empirephoenix/DCBrushedMotorController/sheets/112423_w01_abmessung_1920x1920.jpg

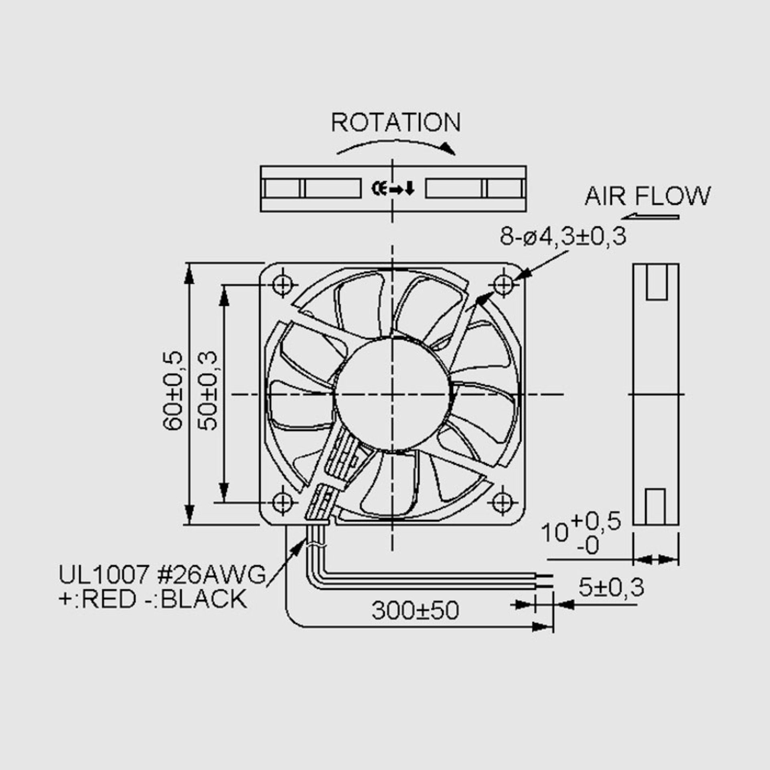
sheets/112423_w01_abmessung_1920x1920.jpg
