empirephoenix/DCBrushedMotorController/sheets/s-l1600.jpg

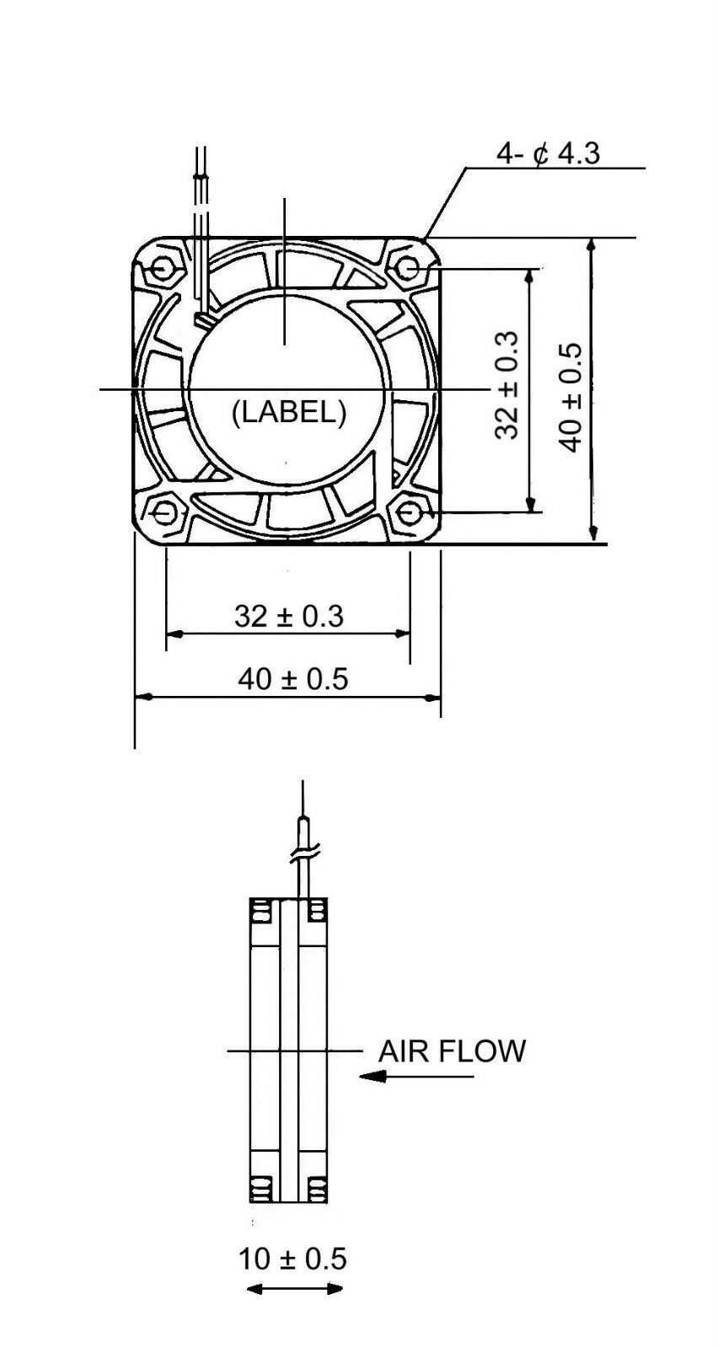
sheets/s-l1600.jpg
