empirephoenix/DCBrushedMotorController/board2/DCMotorController/DCMotorController.kicad_pcb

## KiCad design board2/DCMotorController/DCMotorController.kicad_pcb (2024-08-04)

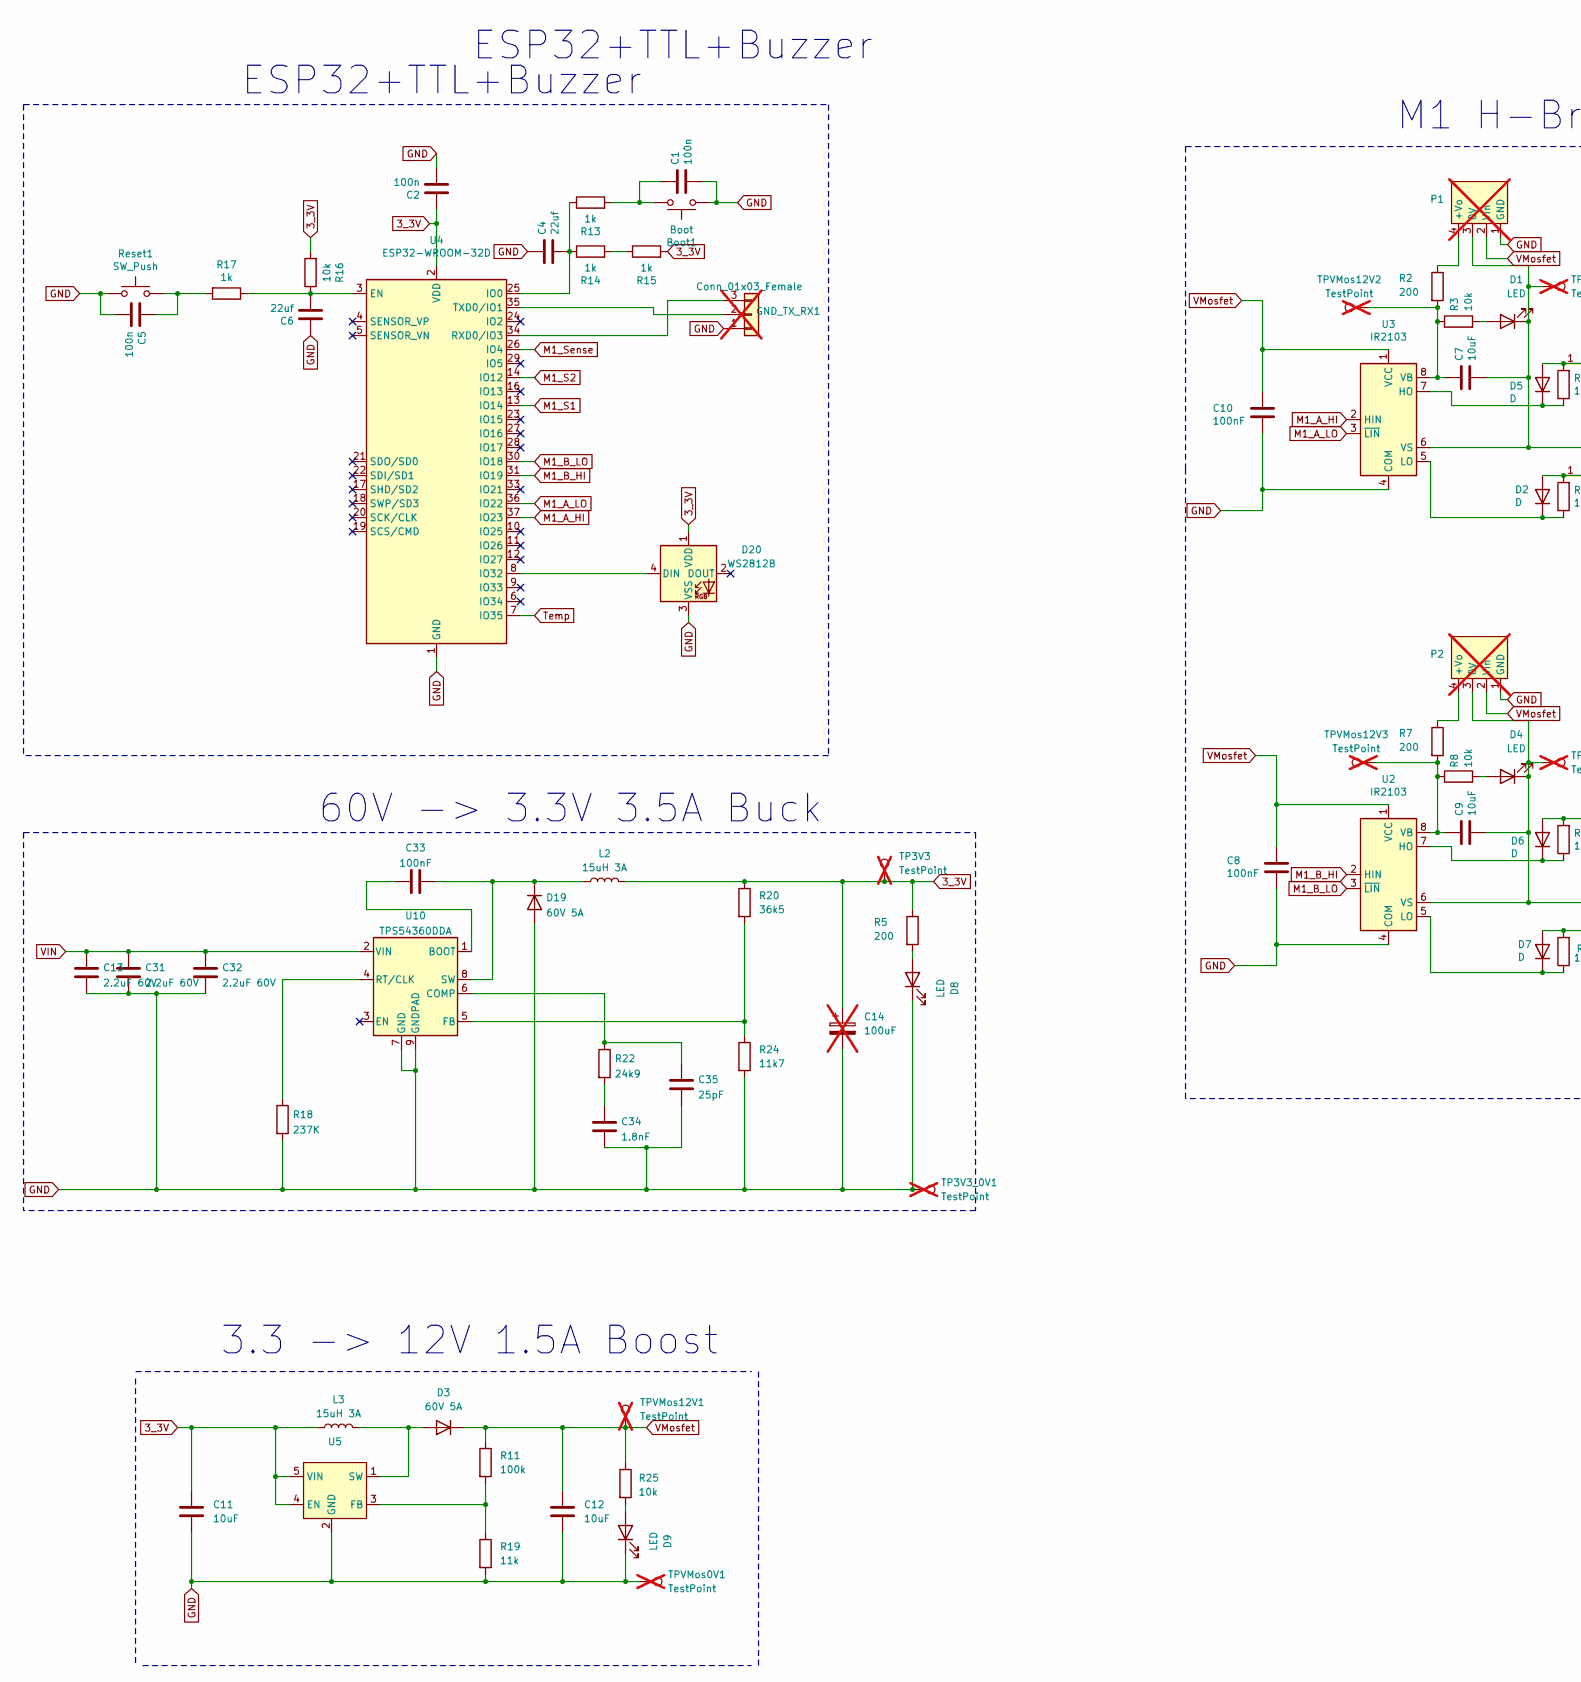
[picture p3: schematic DCMotorController.kicad_sch, part in row 1, column 1]

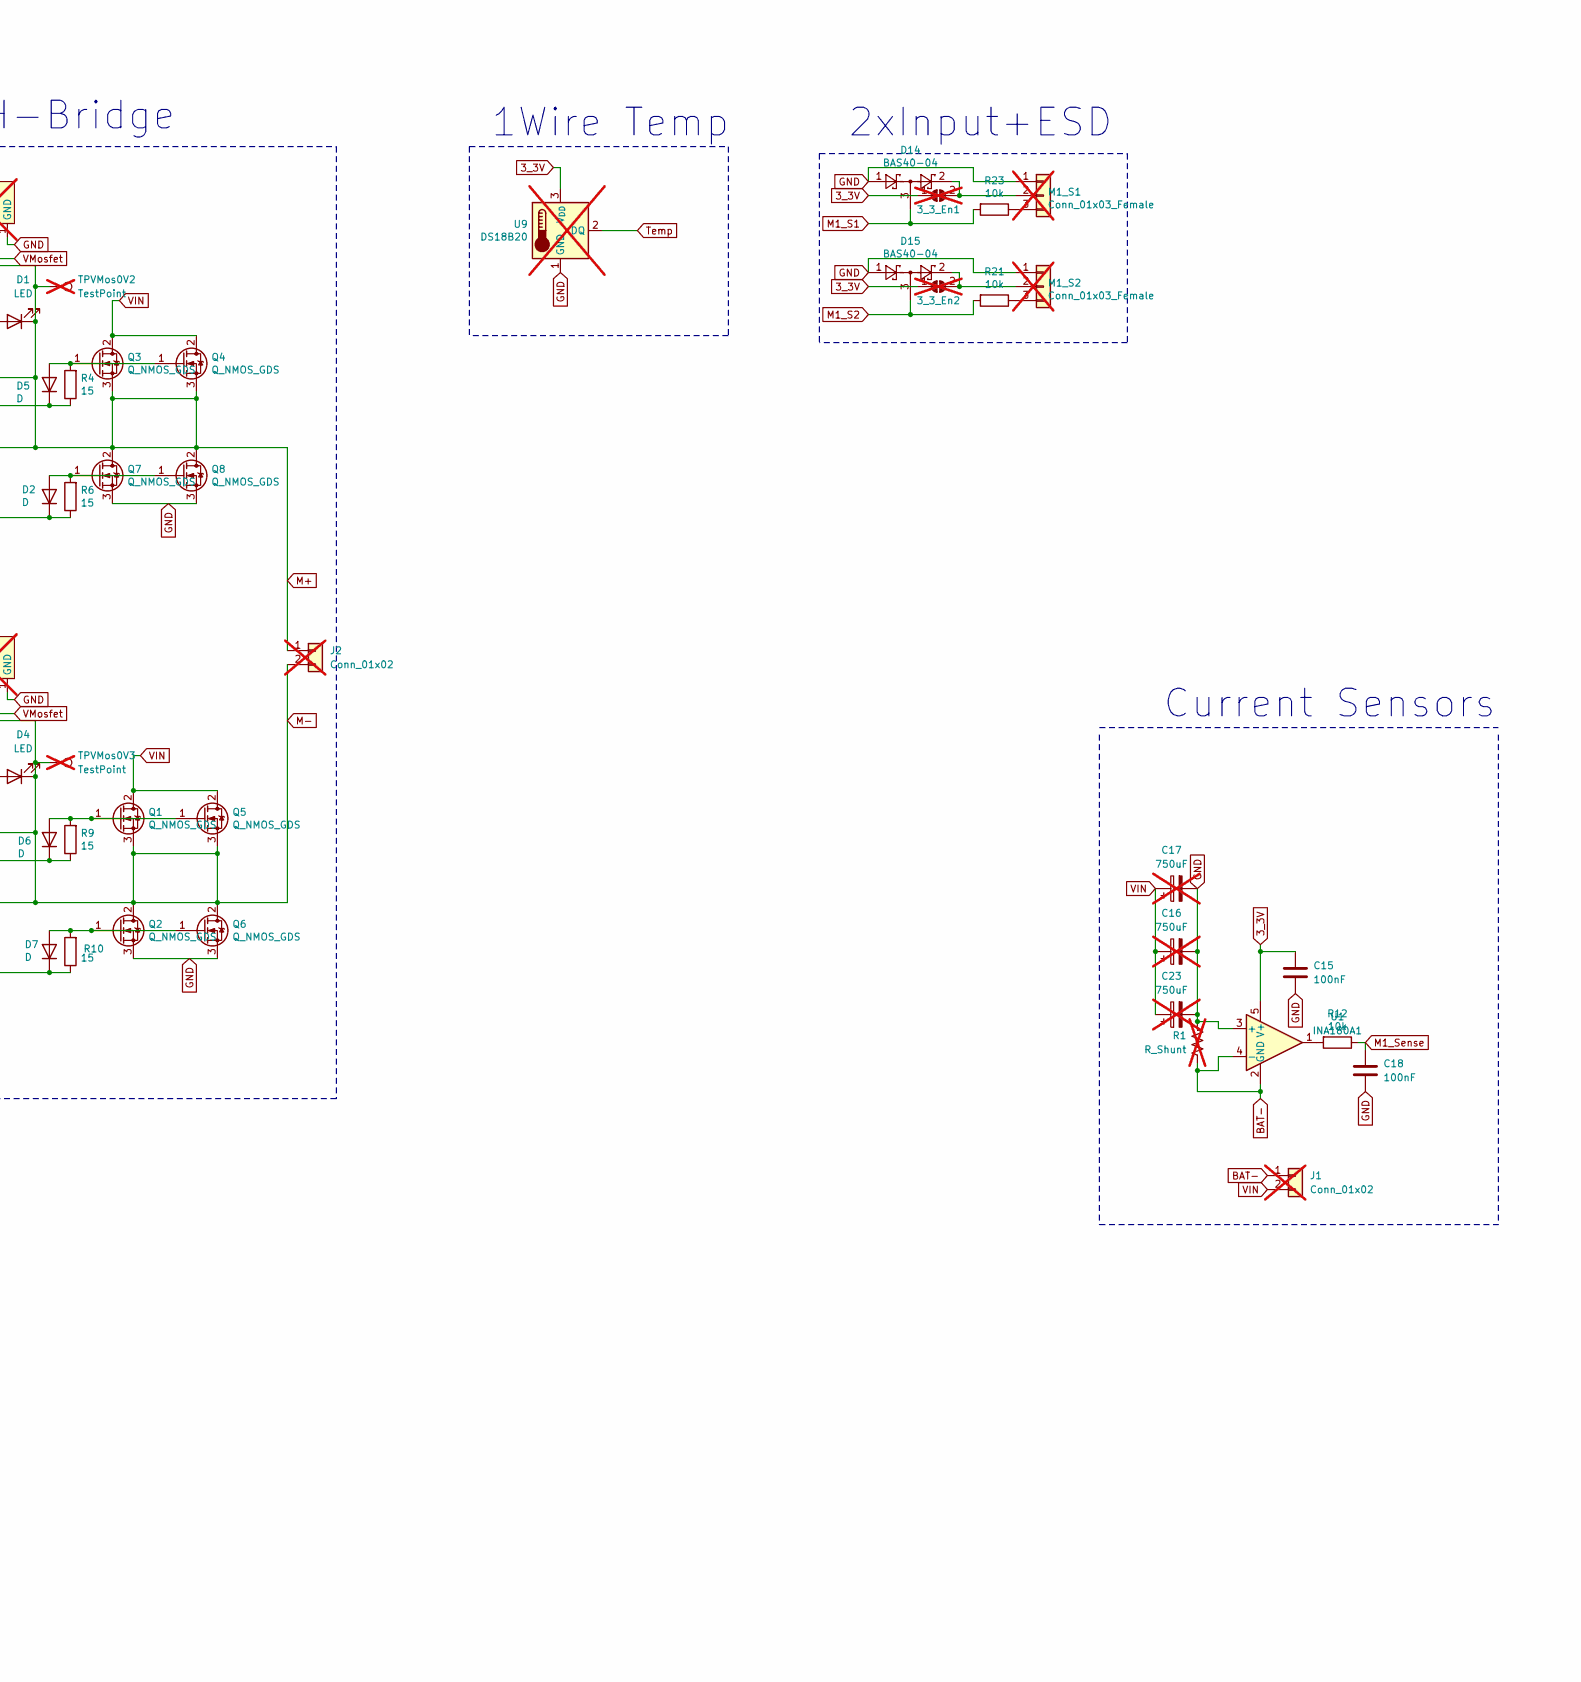
[picture p4: schematic DCMotorController.kicad_sch, part in row 1, column 2]

Parts:
3_3_En1, 3_3_En2: SolderJumper-2_P1.3mm_Open_RoundedPad1.0x1.5mm; not fitted
Boot1: Boot; SW_SPST_CK_RS282G05A3; LCSC C72443
C1, C2, C5: 100n; C_0603_1608Metric; LCSC C14663
C4, C6: 22uf; C_0805_2012Metric; LCSC C5674
C7, C9: 10uF; C_1206_3216Metric; LCSC C13585
C8, C10, C15, C18, C33: 100nF; C_0603_1608Metric; LCSC C14663
C11, C12: 10uF; C_1206_3216Metric
C13, C31, C32: 2.2uF 60V; C_1206_3216Metric; LCSC C920964
C14: 100uF; CP_Radial_D10.0mm_P2.50mm_P5.00mm; not fitted
C16, C17, C23: 750uF; CP_Radial_D12.5mm_P5.00mm; LCSC C316460; not fitted
C34: 1.8nF; C_0603_1608Metric; LCSC C1599
C35: 25pF; C_0603_1608Metric; LCSC C282067
D1, D4, D8, D9: LED; LED_0805_2012Metric
D2, D5, D6, D7: D; D_SOD-123; LCSC C81598
D3, D19: 60V 5A; D_SMA; LCSC C513479
D14, D15: BAS40-04; SOT-23; LCSC C397601
D20: WS2812B; LED_WS2812B_PLCC4_5.0x5.0mm_P3.2mm; LCSC no
GND_TX_RX1: Conn_01x03_Female; PinHeader_1x03_P2.54mm_Vertical; LCSC no; not fitted
J1: Conn_01x02; AMASS_XT60-M_1x02_P7.20mm_Vertical; not fitted
J2: Conn_01x02; AMASS_XT60-F_1x02_P7.20mm_Vertical; not fitted
L2, L3: 15uH 3A; L_10.4x10.4_H4.8; LCSC C151872
M1_S1, M1_S2: Conn_01x03_Female; PinHeader_1x03_P2.54mm_Vertical; LCSC no; not fitted
P1, P2: Converter_DCDC_TRACO_TEA1-xxxx_THT; LCSC C7465190; not fitted
Q1, Q2, Q3, Q4, Q5, Q6, Q7, Q8: Q_NMOS_GDS; TO-252-2; LCSC C110912
R1: R_Shunt; Shunt 1moh 5W; LCSC C695947; not fitted
R2, R5, R7: 200; R_0603_1608Metric; LCSC C25217
R3, R8, R25: 10k; R_0603_1608Metric
R4, R6, R9, R10: 15; R_0603_1608Metric; LCSC C22810
R11: 100k; R_0603_1608Metric; LCSC C22797
R12, R16, R21, R23: 10k; R_0603_1608Metric; LCSC C25804
R13, R14, R15, R17: 1k; R_0603_1608Metric; LCSC C21190
R18: 237K; R_0603_1608Metric_Pad0.98x0.95mm_HandSolder; LCSC C2998117
R19: 11k; R_0603_1608Metric; LCSC C25950
R20: 36k5; R_0603_1608Metric; LCSC C2930095
R22: 24k9; R_0603_1608Metric; LCSC C25962
R24: 11k7; R_0805_2012Metric; LCSC C865154
Reset1: SW_Push; SW_SPST_CK_RS282G05A3; LCSC C72443
TP3V3, TP3V3_0V1: TestPoint; TestPoint_Pad_2.0x2.0mm; not fitted
TPVMos0V1, TPVMos0V2, TPVMos0V3, TPVMos12V1, TPVMos12V2, TPVMos12V3: TestPoint; TestPoint_Pad_2.0x2.0mm; not fitted
U1: INA180A1; SOT-23-5; LCSC C122228
U2, U3: IR2103; SOP-8_3.9x4.9mm_P1.27mm; LCSC C111908
U4: ESP32-WROOM-32D; ESP32-WROOM-32_no_wifi; LCSC C529578
U5: SOT-23-5; LCSC C181744
U9: DS18B20; TO-92_Inline; LCSC lcsc; not fitted
U10: TPS54360DDA; TI_SO-PowerPAD-8_ThermalVias; LCSC C44377

Connections:
3_3V: 3_3_En1.1 (A), 3_3_En2.1 (A), C2.2, C11.1, C14.1, C15.1, D20.1 (VDD), L2.2, L3.1, R5.1, R15.2, R16.2, R20.1, TP3V3.1, U1.5 (V+), U4.2 (VDD), U5.4 (EN), U5.5 (VIN), U9.3 (V_{DD})
BAT-: J1.1, R1.2, U1.2 (GND), U1.4 (-)
GND: Boot1.1, C1.1, C2.1, C4.1, C5.1, C6.1, C8.2, C10.2, C11.2, C12.2, C13.2, C14.2, C15.2, C16.2, C17.2, C18.1, C23.2, C31.2, C32.2, C34.2, C35.2, D8.1 (K), D9.1 (K), D14.1, D15.1, D19.2 (A), D20.3 (VSS), GND_TX_RX1.1, M1_S1.1, M1_S2.1, P1.1 (GND), P2.1 (GND), Q2.3 (S), Q6.3 (S), Q7.3 (S), Q8.3 (S), R1.1, R18.2, R19.2, R24.2, Reset1.1, TP3V3_0V1.1, TPVMos0V1.1, U1.3 (+), U2.4 (COM), U3.4 (COM), U4.1 (GND), U4.15 (GND), U4.38 (GND), U4.39 (GND), U5.2 (GND), U9.1 (GND), U10.7 (GND), U10.9 (GNDPAD)
M1_A_HI: U3.2 (HIN), U4.37 (IO23)
M1_A_LO: U3.3 (~LIN), U4.36 (IO22)
M1_B_HI: U2.2 (HIN), U4.31 (IO19)
M1_B_LO: U2.3 (~LIN), U4.30 (IO18)
M1_S1: D14.3, R23.2, U4.13 (IO14)
M1_S2: D15.3, R21.2, U4.14 (IO12)
M1_Sense: C18.2, R12.1, U4.26 (IO4)
M+: C7.2, D1.1 (K), J2.1, P1.3 (0V), Q3.3 (S), Q4.3 (S), Q7.2 (D), Q8.2 (D), TPVMos0V2.1, U3.6 (VS)
M-: C9.2, D4.1 (K), J2.2, P2.3 (0V), Q1.3 (S), Q2.2 (D), Q5.3 (S), Q6.2 (D), TPVMos0V3.1, U2.6 (VS)
unnamed: 3_3_En1.2 (B), D14.2, M1_S1.2
unnamed: 3_3_En2.2 (B), D15.2, M1_S2.2
unnamed: Boot1.2, C1.2, R13.2
unnamed: C5.2, R17.2, Reset1.2
unnamed: C34.1, R22.2
unnamed: D1.2 (A), R3.2
unnamed: D2.2 (A), Q7.1 (G), Q8.1 (G), R6.2
unnamed: D2.1 (K), R6.1, U3.5 (LO)
unnamed: D3.2 (A), L3.2, U5.1 (SW)
unnamed: D4.2 (A), R8.2
unnamed: D5.2 (A), Q3.1 (G), Q4.1 (G), R4.2
unnamed: D5.1 (K), R4.1, U3.7 (HO)
unnamed: D6.2 (A), Q1.1 (G), Q5.1 (G), R9.2
unnamed: D6.1 (K), R9.1, U2.7 (HO)
unnamed: D7.2 (A), Q2.1 (G), Q6.1 (G), R10.2
unnamed: D7.1 (K), R10.1, U2.5 (LO)
unnamed: D8.2 (A), R5.2
unnamed: D9.2 (A), R25.2
unnamed: C33.2, D19.1 (K), L2.1, U10.8 (SW)
unnamed: D20.4 (DIN), U4.8 (IO32)
unnamed: GND_TX_RX1.2, U4.35 (TXD0/IO1)
unnamed: GND_TX_RX1.3, U4.34 (RXD0/IO3)
unnamed: M1_S1.3, R23.1
unnamed: M1_S2.3, R21.1
unnamed: P1.4 (+Vo), R2.1
unnamed: P2.4 (+Vo), R7.1
unnamed: R12.2, U1.1
unnamed: R14.2, R15.1
unnamed: C9.1, R7.2, R8.1, TPVMos12V3.1, U2.8 (VB)
unnamed: C7.1, R2.2, R3.1, TPVMos12V2.1, U3.8 (VB)
unnamed: C6.2, R16.1, R17.1, U4.3 (EN)
unnamed: C4.2, R13.1, R14.1, U4.25 (IO0)
unnamed: R11.2, R19.1, U5.3 (FB)
unnamed: C33.1, U10.1 (BOOT)
unnamed: C35.1, R22.1, U10.6 (COMP)
unnamed: R20.2, R24.1, U10.5 (FB)
unnamed: R18.1, U10.4 (RT/CLK)
Temp: U4.7 (IO35), U9.2 (DQ)
VIN: C13.1, C16.1, C17.1, C23.1, C31.1, C32.1, J1.2, Q1.2 (D), Q3.2 (D), Q4.2 (D), Q5.2 (D), U10.2 (VIN)
VMosfet: C8.1, C10.1, C12.1, D3.1 (K), P1.2 (Vin), P2.2 (Vin), R11.1, R25.1, TPVMos12V1.1, U2.1 (VCC), U3.1 (VCC)

Notes on the sheet:
Current Sensors
3.3 -> 12V 1.5A Boost
60V -> 3.3V 3.5A Buck
ESP32+TTL+Buzzer
1Wire Temp
2xInput+ESD
M1 H-Bridge

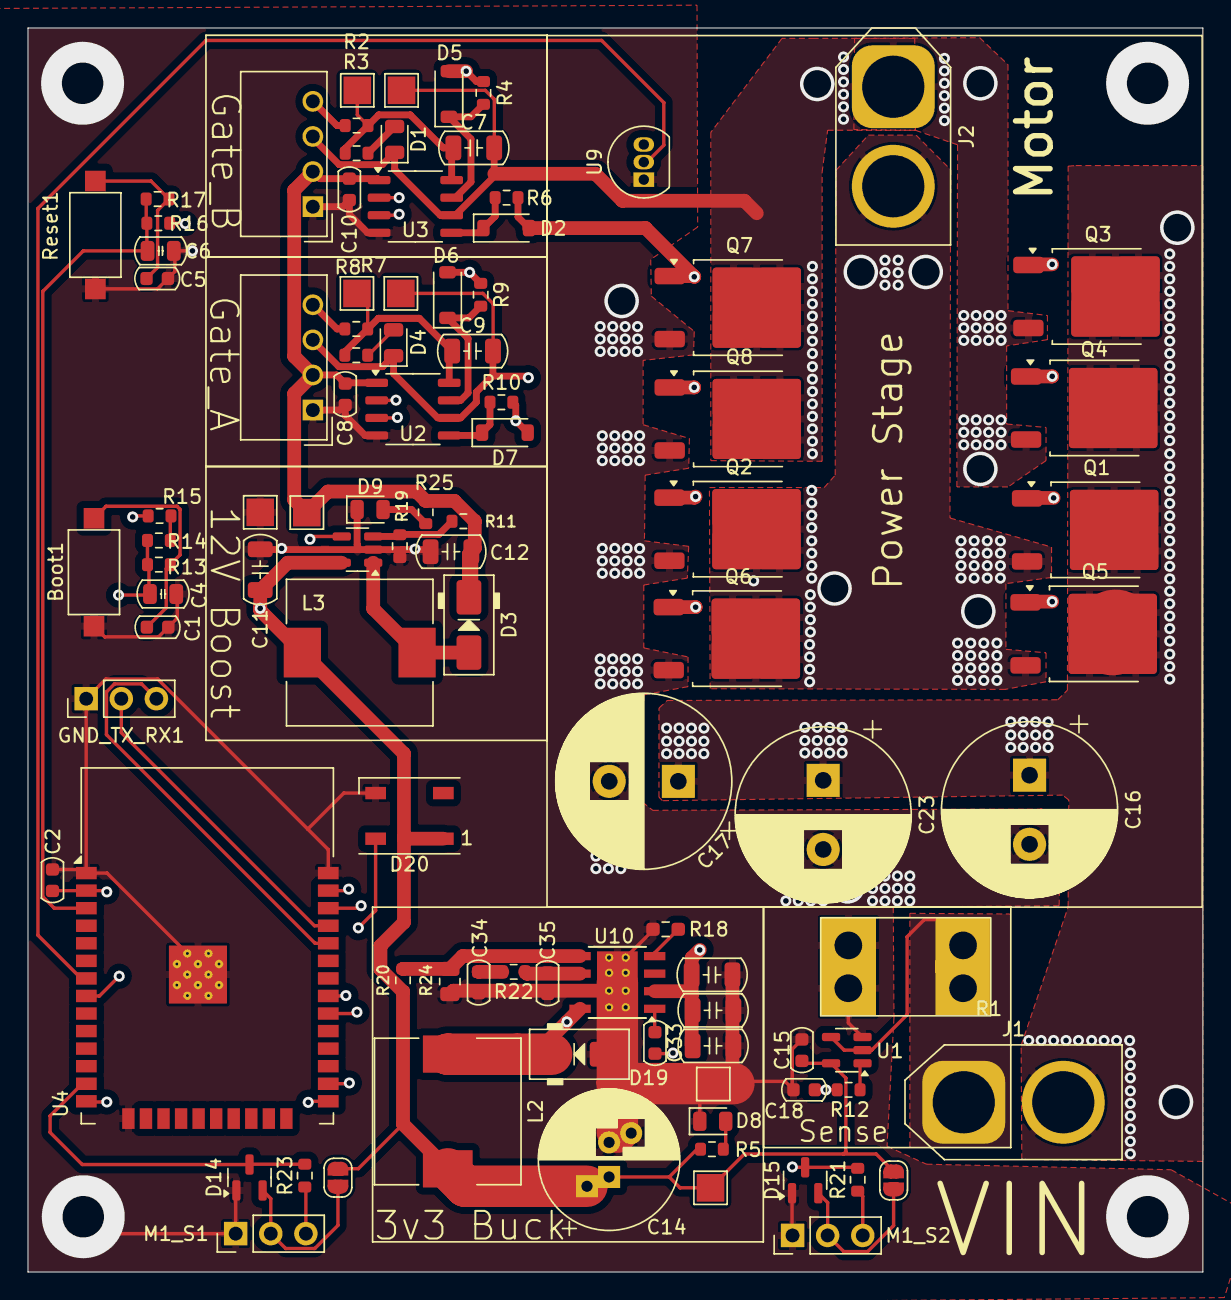
[picture p5: board board2/DCMotorController/DCMotorController.kicad_pcb from above]

Board: 4 copper layers, 85.0 x 90.0 mm, 97 parts (0 on the bottom side), 52 nets.
