empirephoenix/DCBrushedMotorController/board/5V-Downstepper/DCMotorController/DCMotorController.kicad_pcb

## KiCad design board/5V-Downstepper/DCMotorController/DCMotorController.kicad_pcb (2023-06-17)

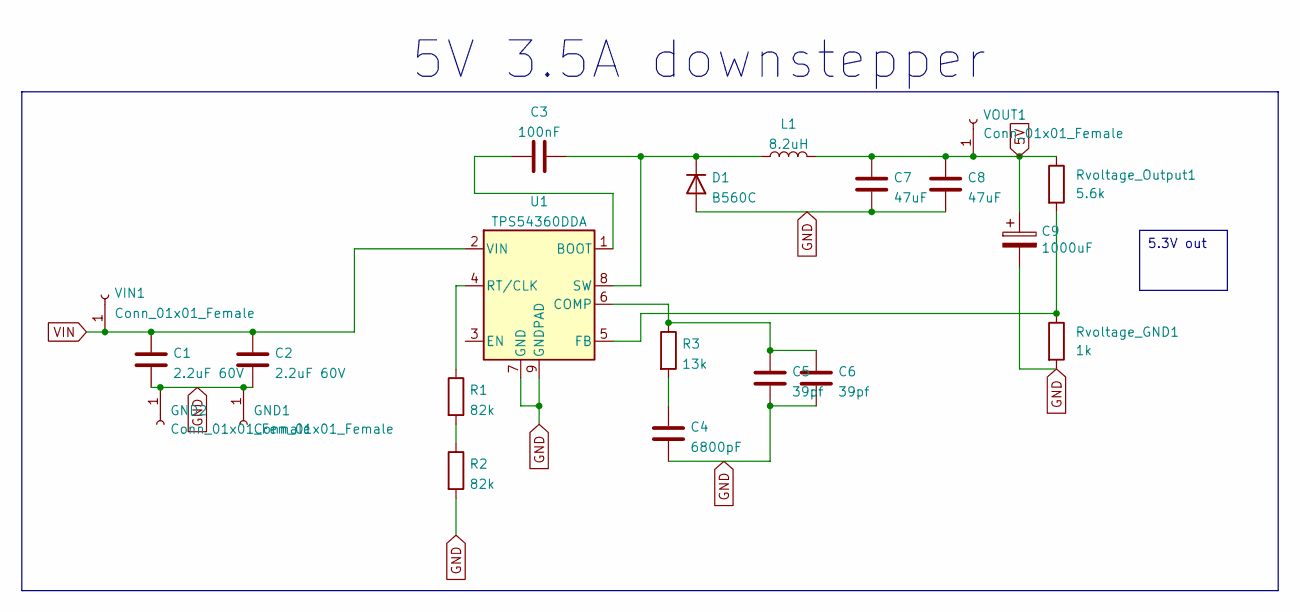
[picture p6: schematic DCMotorController.kicad_sch]

Parts:
C1, C2: 2.2uF 60V; C_1206_3216Metric; LCSC C920964
C3: 100nF; C_0603_1608Metric; LCSC C14663
C4: 6800pF; C_0603_1608Metric; LCSC C1631
C5, C6: 39pf; C_0603_1608Metric; LCSC C1666
C7, C8: 47uF; C_1206_3216Metric; LCSC C96123
C9: 1000uF; CP_Radial_D10.0mm_P5.00mm; LCSC C503217
D1: B560C; D_SMC_Handsoldering; LCSC C85100
GND1, GND2: Conn_01x01_Female; 60A_Wire_solder
L1: 8.2uH; L_12x12mm_H8mm; LCSC C2761921
R1, R2: 82k; R_0603_1608Metric_Pad0.98x0.95mm_HandSolder; LCSC C23254
R3: 13k; R_0603_1608Metric; LCSC C22797
Rvoltage_GND1: 1k; R_0603_1608Metric
Rvoltage_Output1: 5.6k; R_0603_1608Metric
U1: TPS54360DDA; TI_SO-PowerPAD-8_ThermalVias; LCSC C44377
VIN1: Conn_01x01_Female; 60A_Wire_solder
VOUT1: Conn_01x01_Female; 60A_Wire_solder

Connections:
5V: C7.1, C8.1, C9.1, L1.2, Rvoltage_Output1.1, VOUT1.1
GND: C1.2, C2.2, C4.2, C5.2, C6.2, C7.2, C8.2, C9.2, D1.2 (A), GND1.1, GND2.1, R2.2, Rvoltage_GND1.2, U1.7 (GND), U1.9 (GNDPAD)
unnamed: C3.1, U1.1 (BOOT)
unnamed: C3.2, D1.1 (K), L1.1, U1.8 (SW)
unnamed: C4.1, R3.2
unnamed: C5.1, C6.1, R3.1, U1.6 (COMP)
unnamed: R1.1, U1.4 (RT/CLK)
unnamed: R1.2, R2.1
unnamed: Rvoltage_GND1.1, Rvoltage_Output1.2, U1.5 (FB)
VIN: C1.1, C2.1, U1.2 (VIN), VIN1.1

Notes on the sheet:
5.3V out
5V 3.5A downstepper

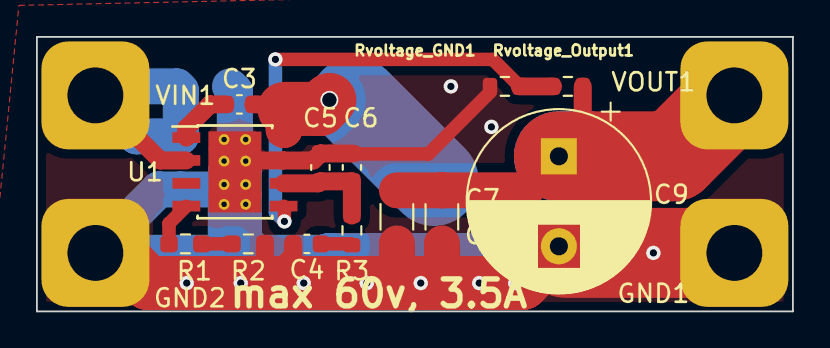
[picture p7: board board/5V-Downstepper/DCMotorController/DCMotorController.kicad_pcb from above]

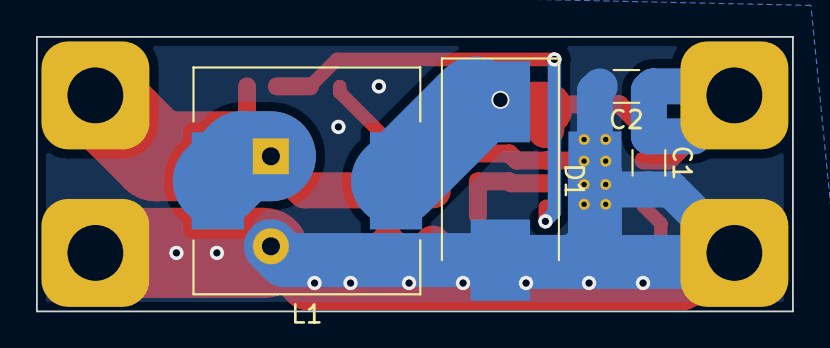
[picture p8: board board/5V-Downstepper/DCMotorController/DCMotorController.kicad_pcb from below]

Board: 2 copper layers, 42.0 x 15.2 mm, 21 parts (4 on the bottom side), 10 nets.
