empirephoenix/DCBrushedMotorController/esp32test/Esp32DeepSleepTest/include/joy_rmt_rc.h

/*

Using ESP32 RMT to read servo pulses sent by radio remote control receiver.
Publishes result to a queue of joy_msg.

Reference: https://docs.espressif.com/projects/esp-idf/en/latest/esp32/api-reference/peripherals/rmt.html
Reference: https://github.com/JustinOng/sumo/blob/master/software/sumo/src/configure_rmt.c
  (via https://www.reddit.com/r/esp32/comments/bivbz1/can_a_esp32_read_the_pwm_signal_of_a_rc_receiver/)

Copyright (c) Roger Cheng

MIT License

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
*/
#ifndef INC_JOY_RMT_RC_H
#define INC_JOY_RMT_RC_H

#include "freertos/FreeRTOS.h"
#include "freertos/queue.h"
#include "freertos/task.h"

#include "driver/rmt.h"

#define axis_count 1

/*
 * @brief Structure to hold RMT configuration information specific to a channel
 */
typedef struct rmt_rc_channel
{
  rmt_channel_t channel;
  gpio_num_t pin;
} rmt_rc_channel;

/*
 * @brief Array of channel-specific RMT configuration parameters
 */
static const rmt_rc_channel rc_channels[axis_count] = {
  {
    RMT_CHANNEL_1,
    GPIO_NUM_14,
  }
  /*,
  {
    RMT_CHANNEL_2,
    GPIO_NUM_12,
  } ,
  {
    RMT_CHANNEL_2,
    GPIO_NUM_13,
  },
    {
    RMT_CHANNEL_3,
    GPIO_NUM_5,
  }*/
};

/*
 * @brief Divide RMT 80MHz by 80 = 1MHz = Each tick is 1us (microsecond)
 */
static const uint8_t rmt_clock_divider = 80;

/*
 * @brief Go into idle after inaction longer than 7ms = 7000us
 */
static const uint16_t rmt_idle_threshold = 7000;

/*
 * @brief Signal shorter than 0.25ms = 250us will be ignored as noise
 */
static const uint8_t rmt_filter_threshold = 250;

/*
 * @brief RC receiver usually sends 1ms = 1000us on the low end
 */
static const uint16_t rc_receive_min = 700;

/*
 * @brief RC receiver usually sends 1.5ms = 1500us as center position
 */
static const uint16_t rc_receive_mid = 1500;

/*
 * @brief RC receiver usually sends 2ms = 2000us on the high end
 */
static const uint16_t rc_receive_max = 2300;

/*
 * @brief FreeRTOS task which reads servo control signals sent by radio
 * remote control receiver and translate them to joystick message.
 * @param pvParam QueueHandle to joy_msg mailbox.
 */

void joy_rmt_rc_read_task(void* pvParam);

#endif // #ifndef INC_JOY_RMT_RC_H
