empirephoenix/DCBrushedMotorController/(commit log)

2022-01-07 initial version
    [DCMotorController.kicad_pcb, DCMotorController.kicad_sch, DCMotorController.sch]
2022-02-04 first version + test firmeware
    [BOM-DCMotorController.csv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]
2022-08-12 Allegro current sensor edition
    [DCMotorController.kicad_pcb, DCMotorController.kicad_sch]
2022-08-12 added voltage converter
    [DCMotorController.kicad_pcb, DCMotorController.kicad_sch]
2022-12-28 updated with newer 5 and 3 v supply, potentiometer supply optional added, current sensor rearangement
    [DCMotorController.kicad_pcb, DCMotorController.kicad_sch]
2023-05-05 update to newer current sensoring
    [BOM-DCMotorController.csv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]
2023-05-12 clamp range extended slightly, fixed 100% duty cycle discharging high side capacitor
    [joy_rmt_rc.h, main.cpp]
2023-06-17 adjusted voltage divider for tps
    [DCMotorController.kicad_pcb, DCMotorController.kicad_sch]
2024-06-16 v2 ordering
    [DCMotorController.kicad_pcb, DCMotorController.kicad_sch]
2024-07-11 add board2 firemware update
    [DCMotorController.kicad_pcb, DCMotorController.kicad_sch]
2024-08-04 fix temp check wrong
    [DCMotorController.kicad_pcb]
2024-08-04 less smoothing, fix current sense pin
    [main.cpp]
